maxtech3d/JoyLight/3d_models/Joylight_Enclosure_TopPart_with_GroveConnectors.stl

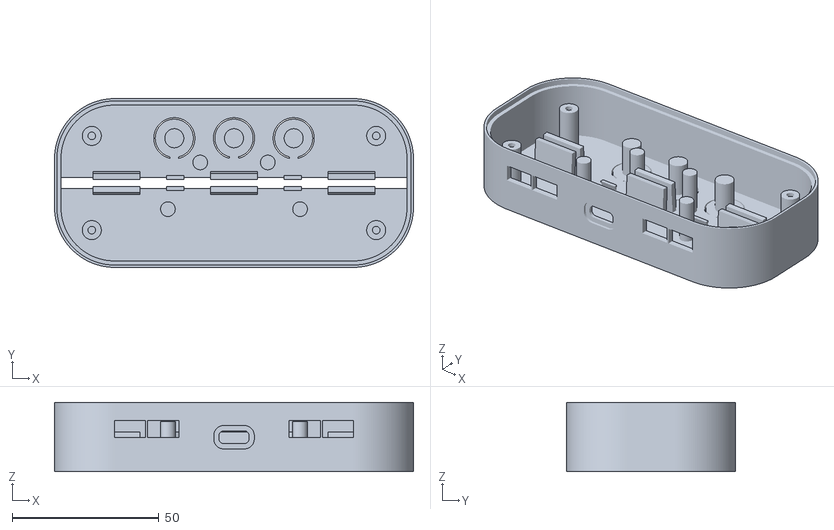
[picture p16: CAD file, 2021-04-18]
3d_models/Joylight_Enclosure_TopPart_with_GroveConnectors.stl
122.2 x 57.5 x 23.6
