maxtech3d/JoyLight/3d_models/step/Joylight_HelperBracket.step

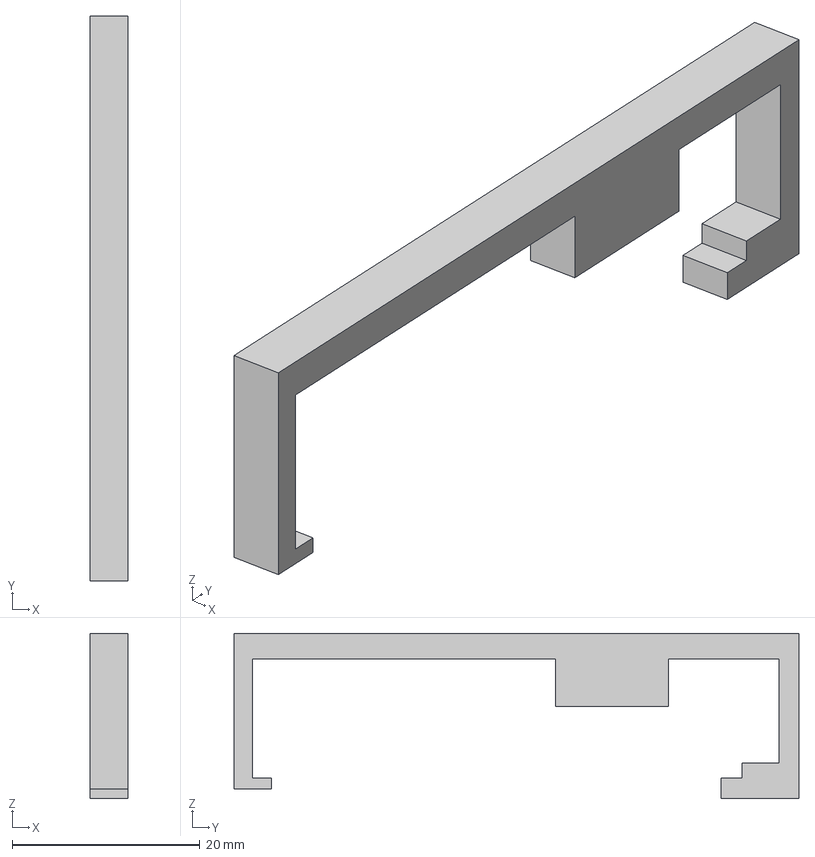
[picture p17: CAD file, 2021-04-18]
3d_models/step/Joylight_HelperBracket.step
4.00 x 60.1 x 17.6 mm
