maxtech3d/JoyLight/pcb/3d models/7 pin male header.stp

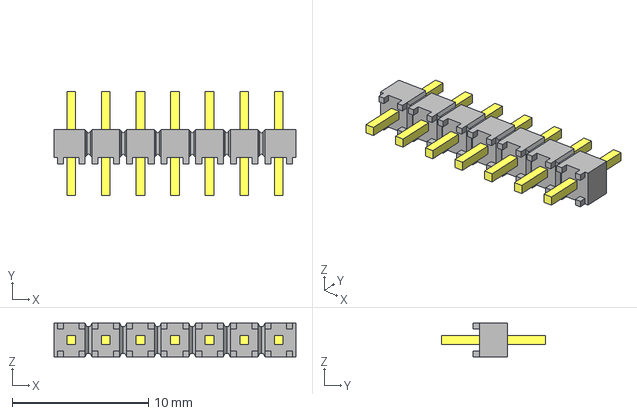
[picture p18: CAD file, 2021-02-23]
pcb/3d models/7 pin male header.stp
17.8 x 7.62 x 2.49 mm
_HMTSW-107-06-G-S-110_body
_HMTSW-107-06-S-110
