maxtech3d/JoyLight/3d_models/step/Joylight_Enclosure.step

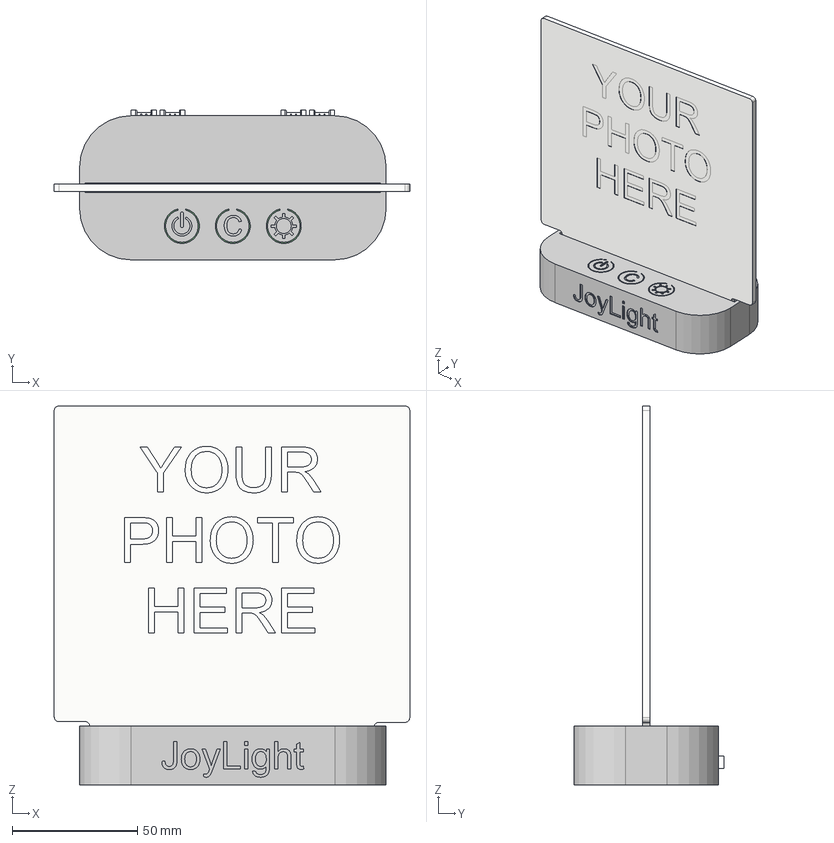
[picture p20: CAD file, 2021-04-18]
3d_models/step/Joylight_Enclosure.step
141.8 x 59.7 x 151.1 mm
Bottom Part
Mounting Tab x 3
Shallow Tabs
Connector Plugs
Sample Panel
