maxtech3d/JoyLight/pcb/3d models/WS2812_RGB_LED_updated.stp

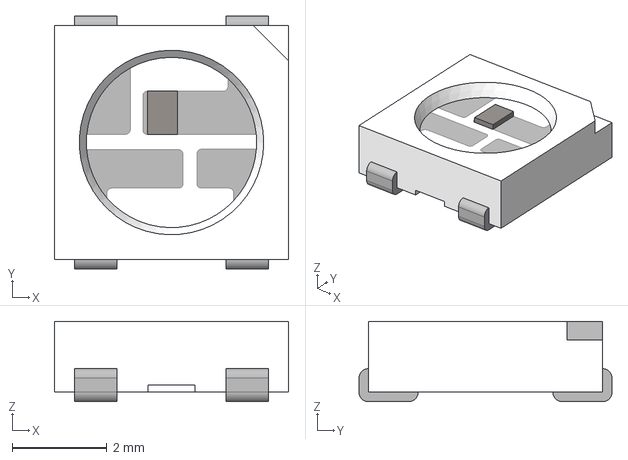
[picture p21: CAD file, 2021-01-18]
pcb/3d models/WS2812_RGB_LED_updated.stp
4.95 x 5.35 x 1.70 mm
