maxtech3d/JoyLight/3d_models/Joylight_Enclosure_BottomPart.stl

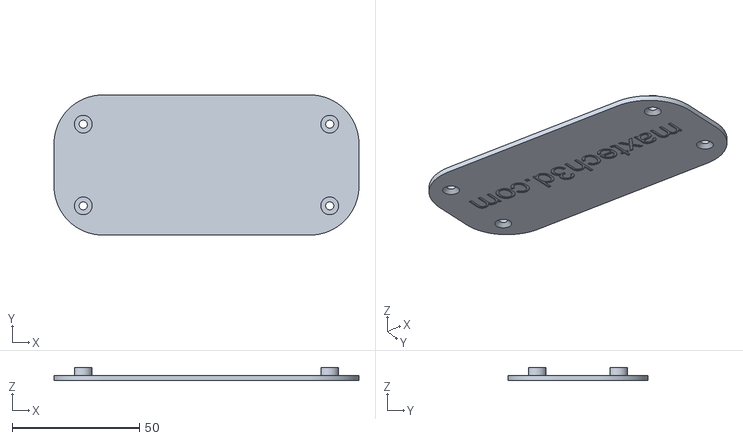
[picture p22: CAD file, 2021-04-18]
3d_models/Joylight_Enclosure_BottomPart.stl
119.8 x 55.1 x 5.00
