maxtech3d/JoyLight/pcb/3d models/Seeeduino Xiao.step

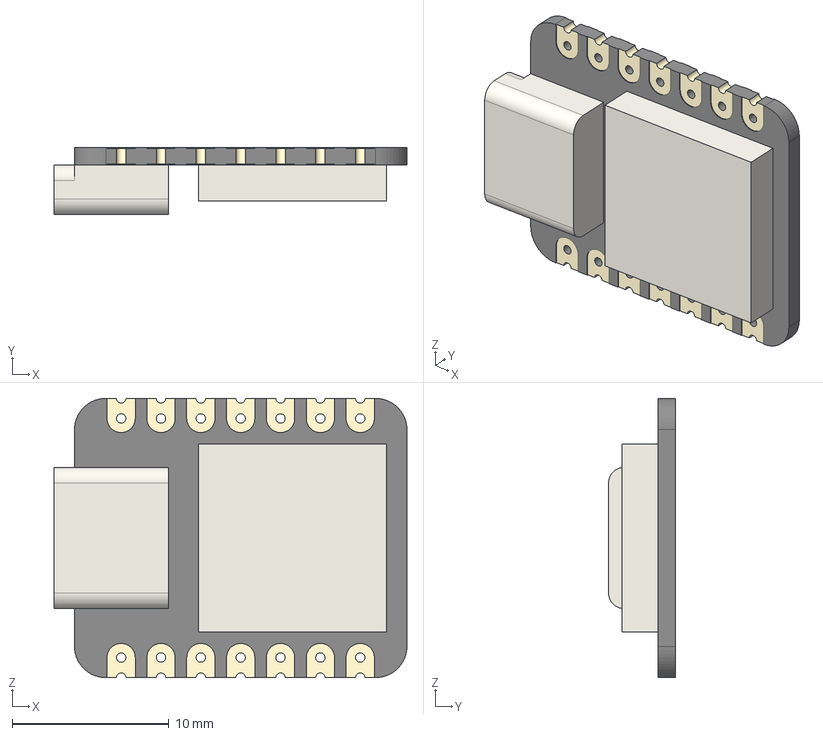
[picture p23: CAD file, 2021-01-18]
pcb/3d models/Seeeduino Xiao.step
22.5 x 4.27 x 17.8 mm
