maxtech3d/JoyLight/pcb/3d models/Grove Connector (lying).STEP

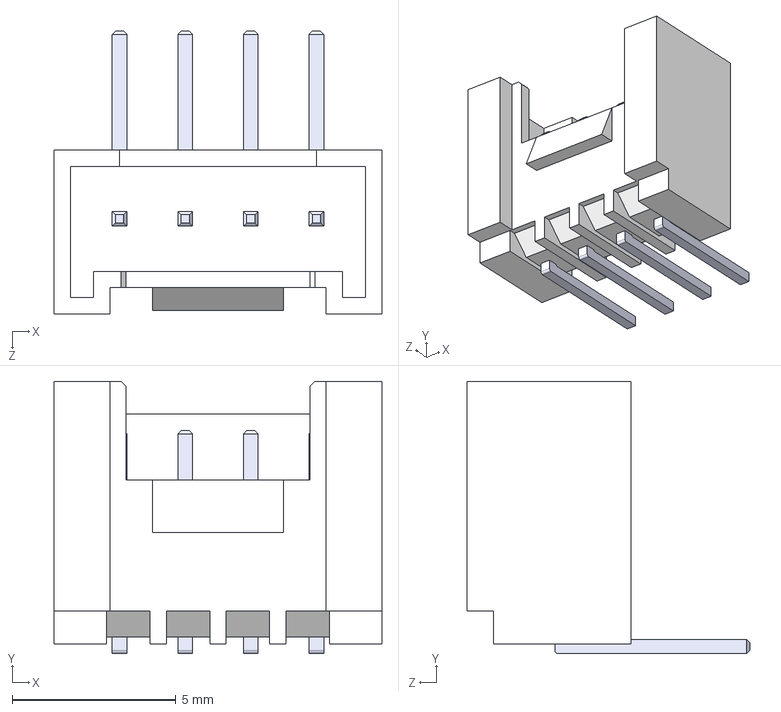
[picture p24: CAD file, 2021-01-18]
pcb/3d models/Grove Connector (lying).STEP
10.0 x 8.30 x 8.62 mm
