maxtech3d/JoyLight/pcb/3d models/ts-1187a-x-g-x.stp

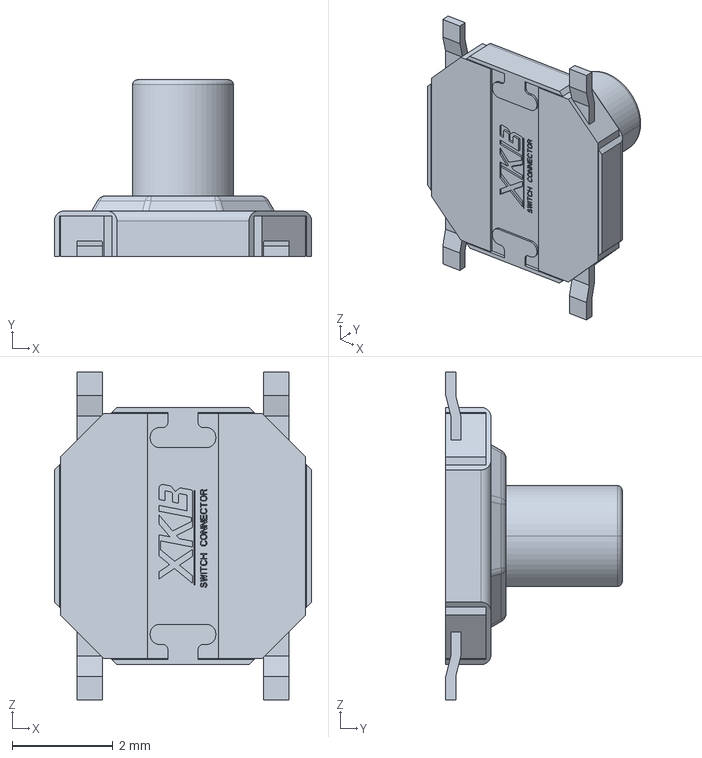
[picture p25: CAD file, 2021-01-18]
pcb/3d models/ts-1187a-x-g-x.stp
5.10 x 3.50 x 6.50 mm
