maxtech3d/JoyLight/(list of files, cad)

Other CAD files:
3d_models/Joylight_HelperBracket.stl
3d_models/f360/Joylight_Enclosure.f3z
