maxtech3d/JoyLight/pcb/JoyLight.kicad_pcb

## KiCad design pcb/JoyLight.kicad_pcb (2021-02-24)

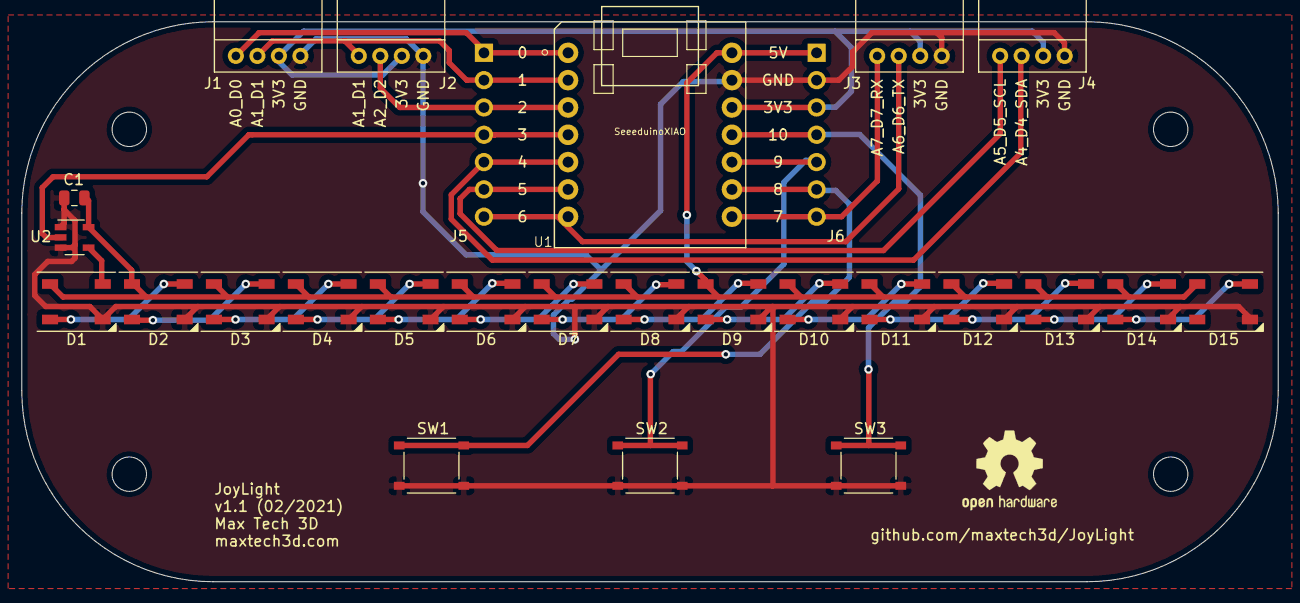
[picture p47: board JoyLight.kicad_pcb from above]

Board: 2 copper layers, 116.8 x 52.1 mm, 31 parts (0 on the bottom side), 29 nets.

Parts:
C1: 100nF; C_0805_2012Metric
D1, D2, D3, D4, D5, D6, D7, D8, D9, D10, D11, D12, D13, D14, D15: WS2812B; LED_WS2812B_PLCC4_5.0x5.0mm_P3.2mm
H1, H2, H3, H4: MountingHole; MountingHole_3.2mm_M3
J1, J2, J3, J4: 110990037; Grove_110990037
J5, J6: Conn_01x07_Male; PinHeader_1x07_P2.54mm_Vertical
SW1, SW2, SW3: SW_SPST; Tactile_Switch_TS-1187A-C-G-B
U1: SeeeduinoXIAO; Seeeduino_XIAO
U2: SN74LV1T125; SOT-23-5

Connections:
+3V3: J1.3, J2.3, J3.3, J4.3, J6.3, U1.12
+5V: C1.1, D1.1, D2.1, D3.1, D4.1, D5.1, D6.1, D7.1, D8.1, D9.1, D10.1, D11.1, D12.1, D13.1, D14.1, D15.1, J6.1, U1.14, U2.5
/A0_D0: J1.1, J5.1, U1.1
/A1_D1: J1.2, J2.1, J5.2, U1.2
/A2_D2: J2.2, J5.3, U1.3
/A4_D4_SDA: J4.2, J5.5, U1.5
/A5_D5_SCL: J4.1, J5.6, U1.6
/A6_D6_TX: J3.2, J5.7, U1.7
/A7_D7_RX: J3.1, J6.7, U1.8
/BTN1_A8_D8: J6.6, SW1.1, U1.9
/BTN2_A9_D9: J6.5, SW2.1, U1.10
/BTN3_A10_D10: J6.4, SW3.1, U1.11
/LED_DIN_A3_D3: J5.4, U1.4, U2.2
GND: C1.2, D1.3, D2.3, D3.3, D4.3, D5.3, D6.3, D7.3, D8.3, D9.3, D10.3, D11.3, D12.3, D13.3, D14.3, D15.3, J1.4, J2.4, J3.4, J4.4, J6.2, SW1.2, SW2.2, SW3.2, U1.13, U2.1, U2.3
unnamed: D1.2, D2.4
unnamed: D1.4, U2.4
unnamed: D2.2, D3.4
unnamed: D3.2, D4.4
unnamed: D4.2, D5.4
unnamed: D5.2, D6.4
unnamed: D6.2, D7.4
unnamed: D7.2, D8.4
unnamed: D8.2, D9.4
unnamed: D10.2, D11.4
unnamed: D9.2, D10.4
unnamed: D11.2, D12.4
unnamed: D12.2, D13.4
unnamed: D13.2, D14.4
unnamed: D14.2, D15.4
