maxtech3d/JoyLight/(commit log)

2021-01-17 Created the PCB project
    [JoyLight.kicad_pcb, JoyLight.sch]
2021-01-17 Work in progress on the schematic
    [JoyLight.sch]
2021-01-18 Finalizing the Schematic and PCB layout for the JoyLight
    [Grove Connector (lying).STEP, JoyLight.kicad_pcb, JoyLight.sch, Seeeduino Xiao.step, WS2812_RGB_LED_updated.stp, ts-1187a-x-g-x.stp]
2021-01-18 Getting the PCB ready for production
    Updated the part numbers
    Added silkscreen info
    [JoyLight.kicad_pcb, JoyLight.sch]
2021-01-21 Finished V1.0 of the PCB
    [JoyLight.kicad_pcb]
2021-02-23 Changed the mounting method of the Xiao
    The Xiao is now mounted by using the pin headers supplied with it instead of directly soldering it to the board
    [7 pin male header.stp, JoyLight.kicad_pcb, JoyLight.sch]
2021-02-24 PCB finishing touches
    - added mounting points
    - added the OSHW logo
    [JoyLight.kicad_pcb, JoyLight.sch]
2021-02-24 Updated schematic
    Missed these files in the previous commit
    [JoyLight.sch]
2021-02-24 Joylight v1.1 PCB
    - minor changes for preparing the board for production
    [JoyLight.kicad_pcb, JoyLight.sch]
2021-02-28 Recovered the schematic
    KiCad messed it up for some reason, had to recover from the backup file
    [JoyLight.sch]
2021-02-28 Added the step model of the PCB
2021-03-16 Added LED animations to the firmware
2021-03-16 Fixed display on animation bug
    The display wouldn't turn off if there was an animation in progress
    [firmware.ino]
2021-04-06 Added ability to force max brightness on long button press
2021-04-18 Added electronics assembly instructions
2021-04-18 Uploaded the 3D models
    [Bottom Part.stl, Helper Bracket.step, Helper Bracket.stl, Joylight Enclosure.f3z, Joylight Enclosure.step, Top Part with Grove Connectors.stl, Top Part.stl]
2021-04-18 Added 3D printing instructions. Renamed the 3d printing files
    [Joylight_Enclosure.f3z, Joylight_Enclosure.step, Joylight_Enclosure_BottomPart.stl, Joylight_Enclosure_TopPart.stl, Joylight_Enclosure_TopPart_with_GroveConnectors.stl, Joylight_HelperBracket.step, Joylight_HelperBracket.stl]
2021-04-18 Enclosure assembly instructions
