maxtech3d/JoyLight/(notices)

Notices in the files:
pcb/3d models/7 pin male header.stp:
FILE_NAME( 'e:/temp/worker_14/temp/exporttempdir_1612_911_Vy7Sc/format_0/HMTSW-107-06-G-S-110.stp', '2021-02-23T15:29:54', ( 'License CC BY-ND 4.0' ), ( 'CADENAS' ), ' ', 'PARTsolutions', ' ' );
